heiga/WAT/Diagrams/CompSchem.png

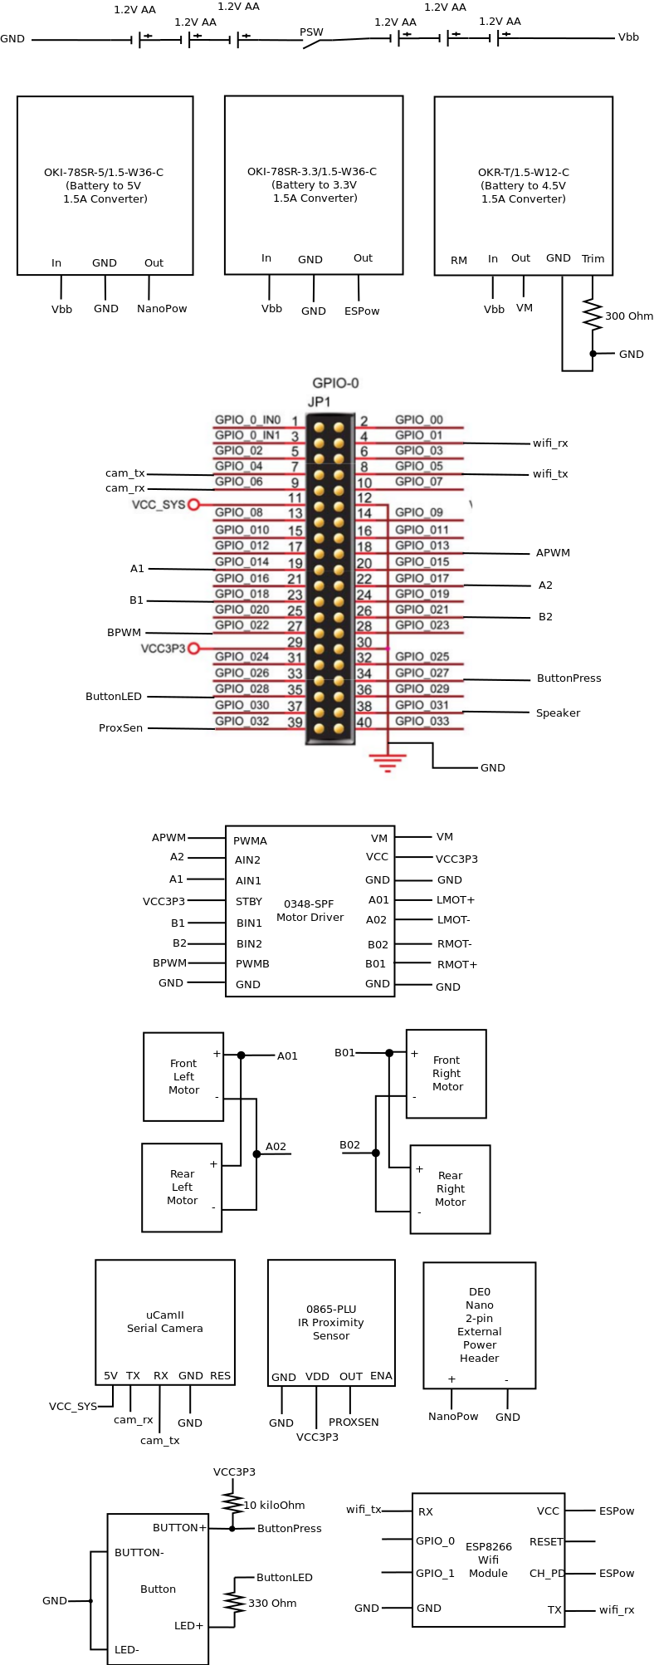
Diagrams/CompSchem.png
