heiga/WAT/Diagrams/NEWspecHWblock.png

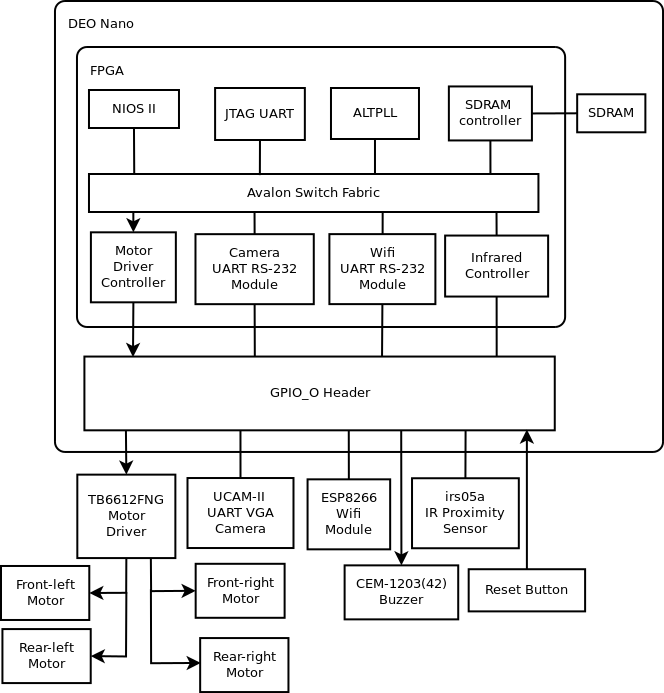
Diagrams/NEWspecHWblock.png
