heiga/WAT/(threads)

Thread 1 (2017-03-26):

INFRARED Sensor Problems

heiga, 2017-03-26:
1) IR is always triggering when the motors are running

2) IR is aimed too low, it is always triggering when the robot is on the ground

heiga, 2017-04-03:
Debounce modified to counter motor noise
Aimed IR higher with sticky tac (temporary fix)

Closed 2017-04-03.

Thread 2 (2017-03-26):

MORE BATTERIES

heiga, 2017-03-26:
While running the motors (RC mode), sometimes the power cuts out and the nano resets.
I'll try putting the bigger capacitor in, if that doesn't work then I think we'll need to run double the batteries.

heiga, 2017-03-26:
What we could do is have the nano store its state in non-volatile memory so after a crash (power outage), it will just reboot and start doing what it was before.
The reset button will not be able to clear state, only reset the WAT, so I can set going to RC mode (on webpage) to clear state.

heiga, 2017-03-26:
Or maybe the problem is that the motors stopping/reversing is causing the voltage drop and I just have to add a delay.
I will investigate further.

heiga, 2017-04-03:
Issue 99% fixed by adding a big ass capacitor.
