heiga/WAT/(commit log)

2017-02-23 Clearing out old broken project
    Can always just revert if this turns out to be not useless
    [imagepro.c, imagepro.h, jconfig.h, jpeglib.h]
2017-02-24 Added camera button ISR and started camera serial commands
    untested, WIP
2017-02-26 Backing up in case the new functions don't work that great
    Turns out there was an entirely different datasheet for the UART that
    isn't linked in QSYS...
2017-02-26 added start of new implementatio for camera
    still need to work out the data packet size stuff
2017-02-27 Basic camera code should be good, will test tomorrow
2017-03-01 Updated camera UART with correct baud rate
    Code still needs fixing but we are definitely getting stable responses
    now.
    [system.h, trolley_system.vhd, trolley_system_cam_uart.v, trolley_system_sysid_qsys_0.v]
2017-03-02 Refactored project so each primary task (cam, motor, wifi) are in their own file
    Saves clutter and prevents a single 1000+ line file
    [camera_test.c, camera_test.h, motor_test.c, motor_test.h, wat_main_test.c, wifi_test.c, wifi_test.h]
2017-03-02 Preliminary attemt at getting IRQ set up for UART
2017-03-02 Added basic motor driving code
2017-03-02 Some logic quirks need to be ironed out but camera is definitely sending ACKs
2017-03-03 Camera communicating, still need remaining functions though
2017-03-03 Stuff from yesterday that has something to do withthe motor.
    Believe it was a tweak to some of the PIO interrupt devices in QSys and
    a bit of minor stuff to the motor.
2017-03-03 Added extra stop commands to current motor test to try and alleviate current draw problems
    [motor_test.c, motor_test.h]
2017-03-08 Copied basic test code to main logic
    Also updated names and added a new file to contain just the interrupts
2017-03-09 Added intertask queues and basic motor code
2017-03-09 Rearranged camera code to sit in the while loop
    also added in needed intertask queues
2017-03-09 Fixed a naming bug in wifi module
    [wat_main_test.c, wifi_test.c, wifi_test.h]
2017-03-12 Pushing whatever this mess is from trying to get camera working
    I think most of it from doing things in Quartus
2017-03-12 Added FIFO UART to project files
    not incorporated yet though
2017-03-13 CAMERA WORKS
    REJOICE
2017-03-21 debounce VHDL operational
    just gotta tinker with the counter time (set at 1 second currently)
2017-03-22 Including source for libjpeg since files are being modified now
    Seriously, of all things why would multiplication fail...
    [jconfig.txt]
2017-03-23 Pushing current WIP to facilitate movement tests
2017-03-26 timer removed from qsys
2017-03-26 RC Mode complete
    However there are some major electronics problems
    [interrupt_peripherals.c, motor.c, wat_main.c, wifi.c, wifi.h]
2017-03-27 Pushing for testing sensor stuff
    also hopefully removing the bsp from future git pushes...
2017-03-28 all merge stuff fixed*
    *hopefully
    [alt_sys_init.c, espComplete.ino, linker.h, motor.c, system.h, wat_main.c, wifi.c]
2017-03-29 Pushing updated imageprocessing
    and camera test stuff
2017-03-29 Image processing tested and passed on board
    Very slow though and still only works in debug... but progress all the
    same.
2017-03-29 Camera and imagepro operational in run mode
2017-03-30 Test code for proximity sensor and speaker
2017-03-30 Camera code shifted (and tested) in main
2017-03-31 qsys camera baud increased to 921600
2017-04-02 Minor bug fixes in autonomous code from earlier
    -Camera posting to wrong queue
    -Tweaked imagepro output (no more math)
    -Tweaked motor bounds for left, right, forward
    [camera.c, imagepro.c, interrupt_peripherals.c, motor.c, motor.h]
2017-04-03 Further refinements to current flashed on code
2017-04-03 RC mode + prox sensor synergized
2017-04-03 Switched camera code to run/flash mode instead of debug
2017-04-07 Fixed forward/reverse in RC mode
    also took out an extra newline in wat_main
    [motor.c, wat_main.c]
2017-04-08 camera baud changed to 115200
2017-04-09 Adjusted motor timing and turning conditions to fix a camera crash
    Not sure how they were related but making the switch stopped the camear
    from crashing
    [camera.c, camera.h, motor.c, wat_main.h, wifi.c]
2017-04-09 Reduced delay durations in motor and camera
2017-04-09 camera baud rate increased to 921K
2017-04-13 DO NOT USE THE MASTER BRANCH, SWITCH TO CAMERABRANCHTHEFIRST
